Gwerr1002/NeuroprotesisINR/bluetoothRPi/Leeme.docx

Ejemplo de referencia para el uso del bluetooth de la RaspberryPi con pybluez
