Gwerr1002/NeuroprotesisINR/np1/Resumen_np1_2022.pdf

## Instituto Nacional de Rehabilitacion´ LGII

Resumen de la version np1 ´

Noviembre 7, 2022

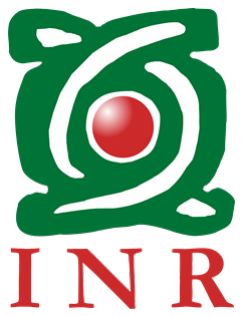
[picture p7: figure]

Controlador portatil de Estimulaci ´ | on El ´ | ectrica Funcional para asistencia de marcha en ´
pacientes con s´ındrome de pie ca´ıdo por EVC.
Programa desarrollado en Python y RaspberryPi 4B. En esta versi ´ | on se trabaj ´ | o sobre los blo- ´
ques de control de la targeta raspberry y del control del estimulador, para lograr programar
secuencias de estimulacion trapezoidales. Esta versi ´ | on es capaz de conectarse con el estimu- ´
lador con el bloque controlStim pero su control no es el optimo, debido a que presenta retrasos ´ y los trapecios no corresponden al tiempo con el que se disena. Se pueden utilizar los siguientes ˜ bloques:
- controlStim: Esta destinado al control del estimulador Rehastim2 en el modo science con env´ıos de estimulos con el comando CHANNELLISTMODE.
- RPI: Destinado al control de los pines GPIO para la deteccion de eventos y un convertidor ´
analogico digital que opera convirtiendo una se ´ | nal de pwm a voltaje. ˜
- trapecio: genera una secuencia de estimulacion trapezoidal para que sea env ´ | ´ıada con el
bloque de controlStim al estimulador Rehastim2.

Los bloques RPI y controlStim se construyeron con programacion orientada a objetos. ´

1
