Gwerr1002/NeuroprotesisINR/np2/Resumen_np2_2022.pdf

## Instituto Nacional de Rehabilitacion´ LGII

Resumen de la version np2 ´

Noviembre 7, 2022


Controlador portatil de Estimulaci ´ | on El ´ | ectrica Funcional para asistencia de marcha en ´
pacientes con s´ındrome de pie ca´ıdo por EVC.
Programa desarrollado en Python y RaspberryPi 4B. En esta versi ´ | on se trabaj ´ | o sobre los blo- ´
ques de control de la targeta raspberry y del control del estimulador, para lograr programar
secuencias de estimulacion trapezoidales. Con estos, es posible realizar la detecci ´ | on de los ´
eventos en sensores de fuerza. El bloque de controlStim no es funcional ya que se tienen algunos errores de retardos y fallo de respuesta en tiempo, se hace uso de temporizadores para
este proposito a diferencia de la versi ´ | on anterior, sin respuestas favorables. Se pueden usar tres ´
bloques los cuales se describen a continuacion: ´
- controlStim: Esta destinado al control del estimulador Rehastim2 en el modo science con env´ıos de estimulos con el comando CHANNELLISTMODE.
- RPI: Destinado al control de los pines GPIO de la taregta raspberry para la deteccion de ´ eventos en sensores de fuerza y un convertidor analogico digital que opera convirtiendo ´ una senal de pwm a voltaje. ˜
- trapecio: genera una secuencia de estimulacion trapezoidal para que sea env ´ | ´ıada con el
bloque de controlStim al estimulador Rehastim2.

Los bloques RPI y controlStim se construyeron con programacion orientada a objetos. ´

1
