Gwerr1002/NeuroprotesisINR/np4/Resumen_np4_2022.pdf

## Instituto Nacional de Rehabilitacion´ LGII

Resumen de la version np4 ´

Noviembre 6, 2022


Controlador portatil de Estimulaci ´ | on El ´ | ectrica Funcional para asistencia de marcha en ´
pacientes con s´ındrome de pie ca´ıdo por EVC.
Programa desarrollado en Python y RaspberryPi 4B. En esta version de trabaj ´ | o sobre progra- ´
macion estructurada, se hace uso del estimulador Rehastim2 para aplicar secuencias de estim- ´
ulacion. Se pueden usar dos bloques los cuales se describen a continuaci ´ | on: ´
- Bucle abierto: Programa secuencias de estimulacion trapezoidales seg ´ | un la configuraci ´ | on´
inicial. Toma en cuenta parametros de la marcha como la cadencia y el periodo de apoyo. ´
- Bucle cerrado: Para este modo son necesarios cuatro sensores de fuerza y el circuito
de acondicionamiento acorde para la deteccion del apoyo del tal ´ | on y del antepi ´ | e. Este ´
bloque realiza un control de los pines GPIO de la targeta RaspberryPi para la deteccion´ de los eventos en los sensores. Se aplican est´ımulos trapezoidales acordes con el evento detectado, en el canal respectivo del estimulador Rehastim2, bajo los parametros config- ´ urados inicialmente (tiempo se subida, meseta y bajada de la senal trapezoidal). ˜
Ambos bloques permiten configurar parametros de la estimulaci ´ | on como el ancho de los pulsos ´
y el intervalo de estimulacion. Estos bloques se programaron para hacer las tareas anterior- ´ mente descritas y hacen uso de otros tres bloques: Uno se dedica exclusivamente al control de
la targeta RaspberryPi. Utiliza a un convertidor digital analogico que convierte una se ´ | nal PWM ˜
a voltaje; El segundo y tercer bloque estan dedicados al control del estimulador, establece co- ´ municacion entre la targeta Raspberry y el estimulador Rehastim2. Cabe recalcar que estos ´
ultimos tres bloques se hicieron con programaci ´ | on orientada a objetos y los presentados ante- ´
riormente (bucle abierto y cerrado) con programacion estructurada. ´

1
