Gwerr1002/NeuroprotesisINR/np6/Resumen_np6_2022.pdf

## Instituto Nacional de Rehabilitacion´ LGII

Resumen de la version np6 ´

Noviembre 6, 2022


Controlador portatil de Estimulaci ´ | on El ´ | ectrica Funcional para asistencia de marcha en ´
pacientes con s´ındrome de pie ca´ıdo por EVC.
Programa desarrollado en Python y RaspberryPi 4B. En esta version de trabaj ´ | o sobre progra- ´
macion orientada a objetos, se hace uso del estimulador Rehastim2 para aplicar secuencias ´
de estimulacion. A diferencia de la versi ´ | on anterior esta es m ´ | as precisa ya que se ten ´ | ´ıa una
variacion de intervalo de estimulaci ´ | on mayor en la pasada. Se pueden usar dos bloques los ´
cuales se describen a continuacion: ´
- Bucle abierto: Programa secuencias de estimulacion trapezoidales continuas, seg ´ | un la ´
configuracion inicial. Calcula la duraci ´ | on de la estimulaci ´ | on y la modulaci ´ | on trapezoidal ´
acorde a los parametros dados (cadencia, tiempo de subida, bajada, duty cycle, msi y cor- ´
riente maxima de estimulaci ´ | on). Los siguientes son los par ´ | ametros que permite modificar ´
el programa:

– candency: cadencia indicada en zancadas por minuto.
– duty cycle: ciclo de trabajo de cada trapecio, 1 equivale al 100% en terminos del inverso de la cadencia.
– corriente max: corriente maxima del trapecio en milliamperes. ´
– msi : Main Stimulation Interval, debe indicarse en millisegundos, el m´ınimo es de 8ms. Por motivos de la aplicacion se debe cuidar que no supere el tiempo de ´ WATCHDOG que es de 1200 ms.
– pulse width: Ancho de pulso en microsegundos [0,500 us]
– t subida: El tiempo de subida que requiere el trapecio en millisegundos.
– t bajada: Tiempo de bajada del trapecio en millisegundos.
- Bucle cerrado: Para este modo son necesarios cuatro sensores de fuerza y el circuito
de acondicionamiento acorde para la deteccion del apoyo del tal ´ | on y del antepi ´ | e. Este ´
bloque realiza un control de los pines GPIO de la targeta RaspberryPi para la deteccion´ de los eventos en los sensores. Se aplican est´ımulos trapezoidales acordes con el evento detectado, en el canal respectivo del estimulador Rehastim2, bajo los parametros config- ´
urados inicialmente. Este modo cuenta con un boton de paciente el cu ´ | al tiene la funci ´ | on´
de parar la estimulacion y salir del bucle. Par ´ | ametros de estimulaci ´ | on: ´

– msi : Main Stimulation Interval, debe indicarse en millisegundos, el m´ınimo es de
8. Por motivos de la aplicacion se debe cuidar que no supere el tiempo de WATCH- ´ DOG que es de 1200 ms

1

– t subida: El tiempo de subida que requiere el trapecio en millisegundos

– t bajada: Tiempo de bajada del trapecio en millisegundos

– t meseta: Tiempo de meseta del trapecio en millisegundos

– pulse width: Ancho de pulso en microsegundos [0,500 us]

Ambos bloques permiten configurar parametros de la estimulaci ´ | on como el ancho de los pulsos ´
y el intervalo de estimulacion, tambi ´ | en permiten guardar las secuencias de estimulaci ´ | on que ´
se aplicaron al paciente. Estos bloques se programaron para hacer la tarea anteriormente descrita y hacen uso de otros tres bloques: Uno se dedica exclusivamente al control de la targeta
RaspberryPi, a diferencia de la version anterior se utiliza al convertidor digital anal ´ | ogico en ´
el modo Sample Hold; El segundo y tercer bloque estan dedicados al control del estimulador ´ Rehastim2, establece comunicacion entre la targeta Raspberry y el estimulador. ´

2
