Gwerr1002/NeuroprotesisINR/APP1/resources/INR_1.png

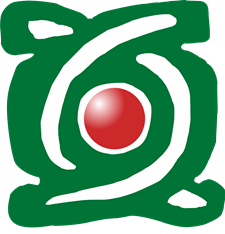
APP1/resources/INR_1.png
