Gwerr1002/NeuroprotesisINR/GUI/INR.png

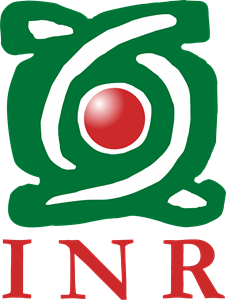
GUI/INR.png
