Gwerr1002/NeuroprotesisINR/APP1/resources/trapecio_traslapado.py

from resources.controlStim import CntrlStim
from resources.trapecio import getTrapecio
from numpy import where

def getTrapecio_traslapado(t_s1,t_b1,t_m1,cmax1,t_s2,t_b2,t_m2,cmax2,t_traslape,pw,msi,canales = (6,7)):
    t, v1 = getTrapecio(t_s1,t_b1,t_m1,msi,cmax1)
    _, v2 = getTrapecio(t_s2,t_b2,t_m2,msi,cmax2)
    v,i,j = [],0,0
    traslape=where(t<=t_traslape)[0][-1] #Muestra en la cual se traslapa (aproximado acorde con msi y t_traslape)
    TOT= len(v1)+len(v2)
    cntrl = True
    while len(v) != TOT:
        if i<traslape:
            v.append((pw,msi,v1[i],canales[0]))
            i += 1
        elif i>=traslape and i<len(v1):
            if cntrl:
                v[-1] = (pw,msi/2,v[-1][2],v[-1][3])
                cntrl = False
            v.append((pw,msi/2,v2[j],canales[1]))
            j += 1
            v.append((pw,msi/2,v1[i],canales[0]))
            i += 1
        else:
            v.append((pw,msi,v2[j],canales[1]))
            j += 1
    #
    return v,traslape

def getgraf_trapecio_traslapado(v,msi,traslape):
    t1,t2 = [],[]
    for i,a in enumerate(v):
        if a[-1] == 6:
            if a[1] == msi:
                t1.append(i*msi)
            else:
                t1.append(t1[-1]+msi)
    #
    c1 = [c for _,msi,c,canal in v if canal == 6]
    #
    aux = t1[traslape-1]+msi/2
    for a in v:
        if a[-1] == 7:
            t2.append(aux+msi)
            aux = t2[-1]
    #
    c2 = [c for _,msi,c,canal in v if canal == 7]
    return (t1,c1), (t2,c2)

if __name__ == '__main__':
    import matplotlib.pyplot as plt
    msi = 20
    pw = 300
    t_traslape = 200
    v,traslape = getTrapecio_traslapado(100,100,200,20,200,200,300,15,t_traslape,pw,msi)
    (t1,c1),(t2,c2)=getgraf_trapecio_traslapado(v,msi,traslape)
    plt.step(t1,c1)
    plt.step(t2,c2)
    plt.show()
