Gwerr1002/NeuroprotesisINR/(commit log)

2022-11-12 Primer subida
    Cree este repositorio del trabajo que he hecho en mi servicio social en el INR para tener una copia de respaldo
    [Caracterizacion 1 de la versión np6.xlsx, Caracterizaciones de la versión np5.xlsx]
2022-11-12 Hoy agregué el bucle abierto
    Esta version del bucle abierto debería correr en linux y windows, además con la clase controlStim se debería poder programar estimulaciones con msi específicos, pulsewidth y corrietnes
2022-11-16 Ajustes bucle abierto y np7 Realicé correcciónes y apliqué cambios en la version de bucle abierto (carpeta) y np7, los cambios fueron en el controlStim.py para poder realizar secuencias más complejas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
2022-11-16 Cambios en np7 y bucle abierto
    Terminé de realizar todos los ajustes pertinentes a la actualización anteriormente hecha principalmente debido al cambio en controlStim
2022-11-18 Cambios en bucle abierto Probablemente hice ajustes y resolví errores
    [trapecio_traslapado.py]
2022-11-18 Solución a errores Modifiqué los errores generados debido al commit anterior y la fusión
    [trapecio_traslapado.py]
2022-11-20 Hice algunos comentarios Los comentarios fueron para indicar los canales de estimulación
2022-11-20 Comencé a hacer la GUI
    La gui para que sea más fácil el uso de los programas hechos
2022-11-20 Correciones
    Corregí el error generado por git
    [trapecio_traslapado.py]
2022-11-23 Hice algunos cambios en el bucle abierto y cerrado Los cambios fueron en la versión np6 y bucle abierto para modificar por separado las corrientes de los canales. Agregue sonidos distintos para cada 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
2022-11-26 Cambios en la GUI y actualización de los programas prueba de CntrlStim Hice unos cambios a la GUI. Presumiblemente esta podría ser la versiòn final del diseño. Falta implementar y agregar el còdigo e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
2022-12-01 Cambios finales en la GUI Principalmente traduje la GUI de xml a python
2022-12-04 Lógica de la app comencé con la lógica de la GUI y terminé el bucle abierto
2022-12-08 GUI actualizacion Terminé el trapecio traslapado y seguí con el modo usuario. Trabajé con la apertura y cierre de archivos.
2022-12-08 lectura de archivos anad{i un script para la lectura de archivos
2022-12-15 modo usuario termine el modo usuario
2022-12-15 modulaciones hice algunos cambios en el script modulations
